jacky4566/BRZFRS_Breakout_withCAN/6376430-2/6376430-2.step

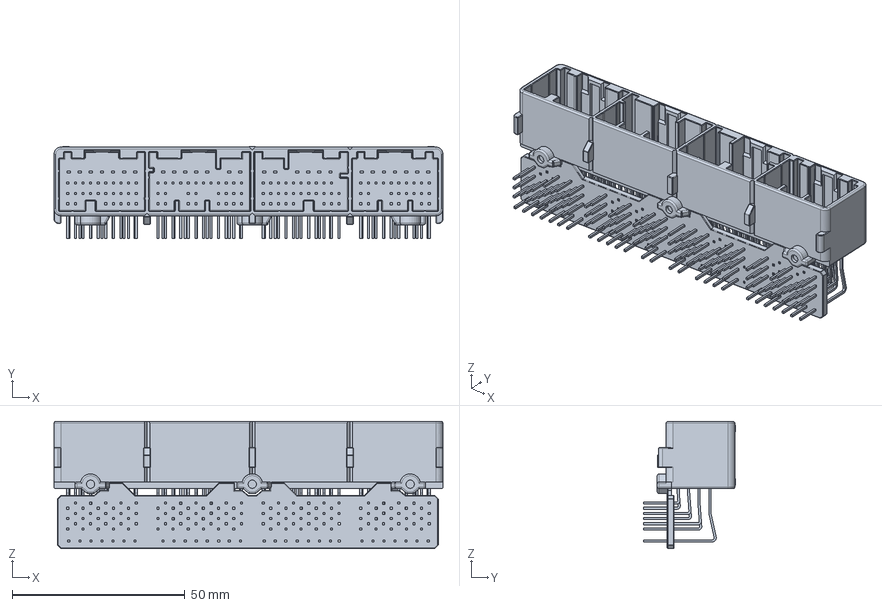
[picture p2: CAD file, 2026-10-14]
6376430-2/6376430-2.step
112.7 x 26.7 x 36.9 mm
