jacky4566/BRZFRS_Breakout_withCAN/BRZ_Breakout_withCAN.kicad_pcb

## KiCad design BRZ_Breakout_withCAN.kicad_pcb (2026-10-14)

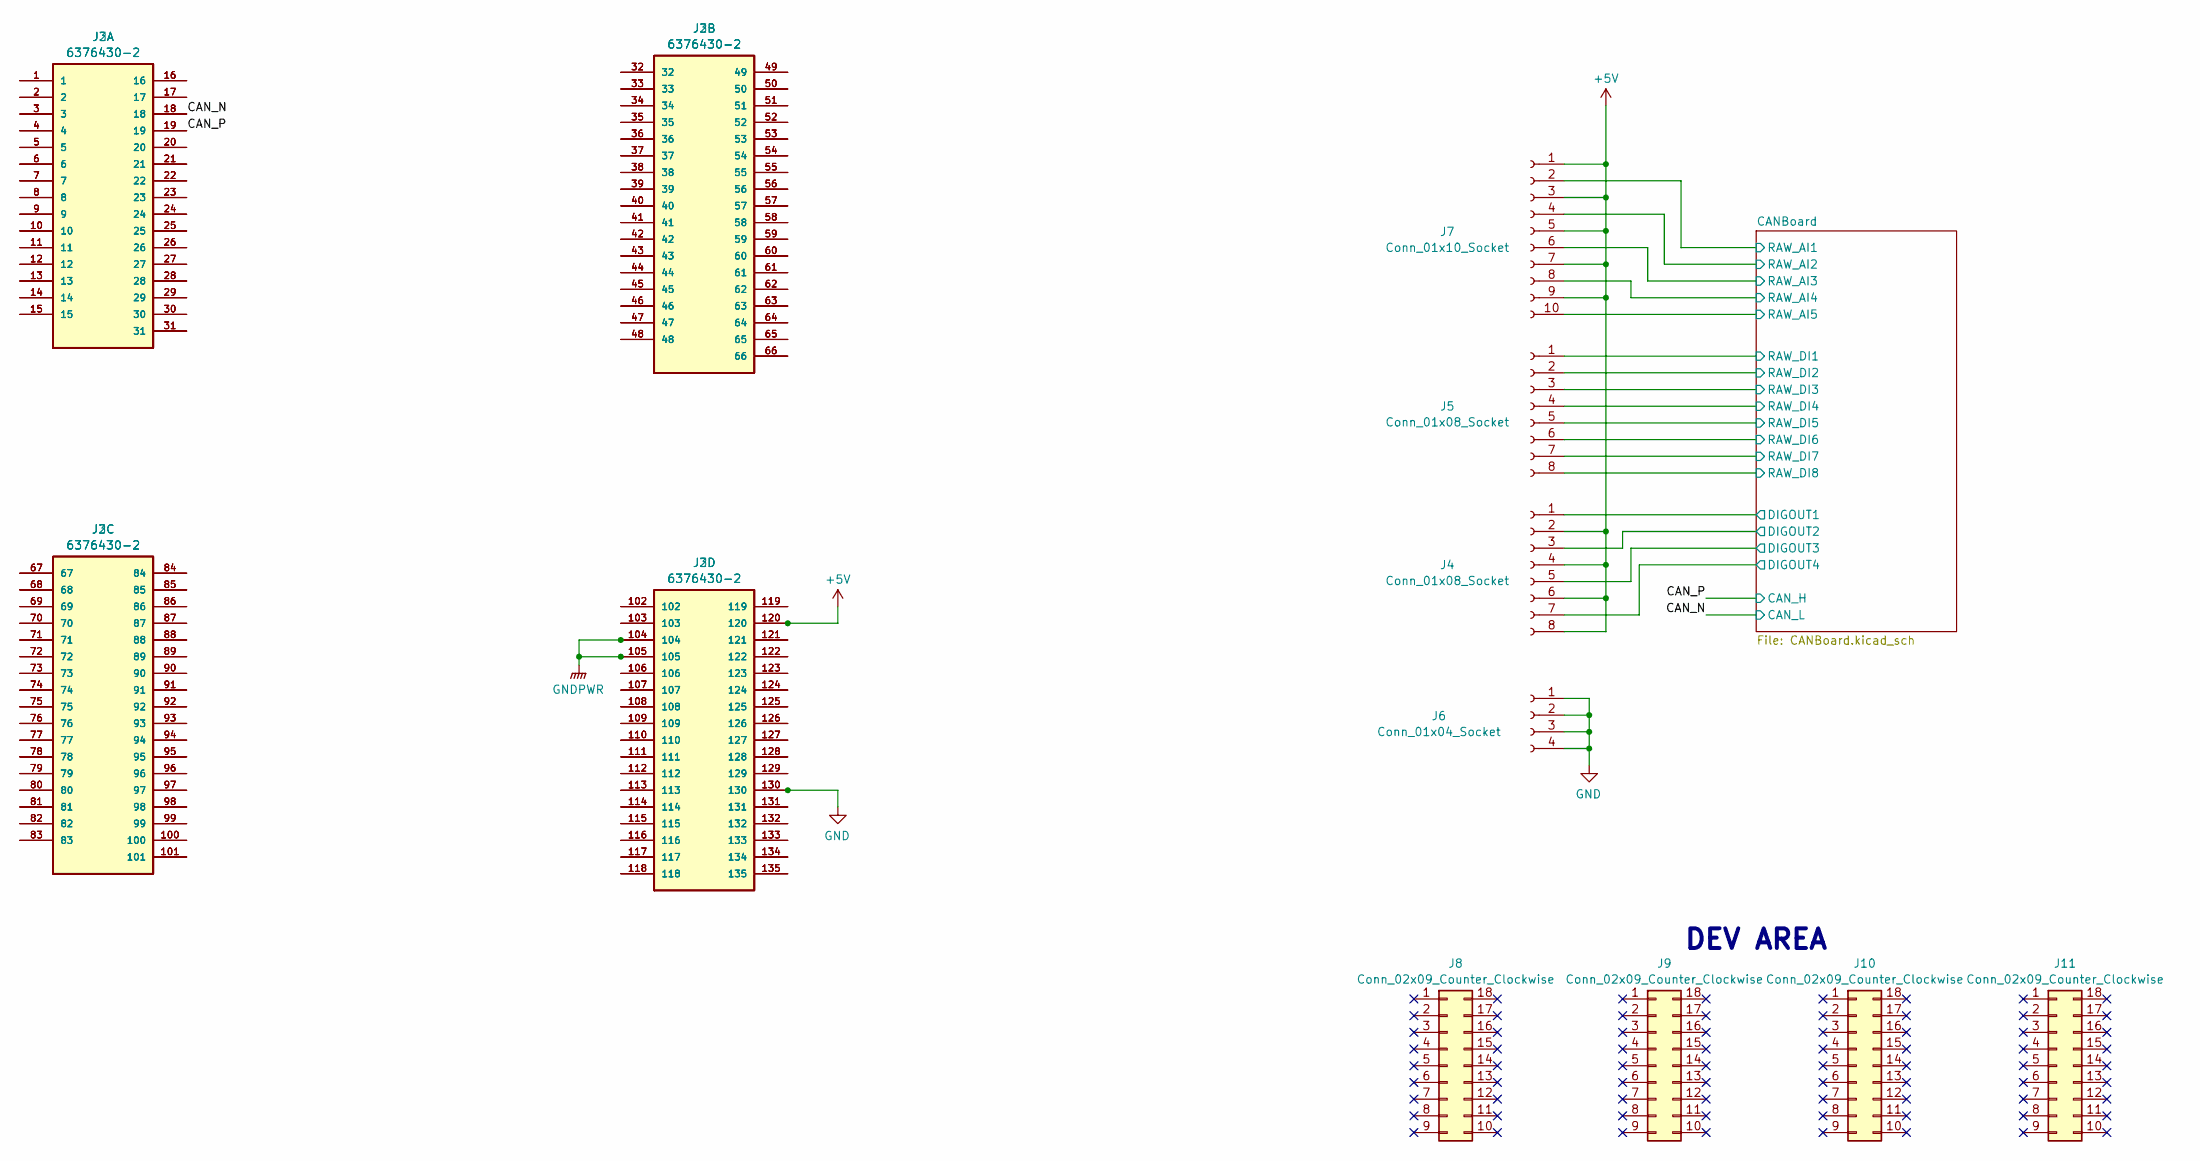
[picture p3: schematic BRZ_Breakout_withCAN.kicad_sch]

Parts:
J2, J3: 6376430-2; TE_6376430-2; MPN 6376430-2; Digi-Key_PN 17-6376430-2-ND
J4, J5: Conn_01x08_Socket; PinHeader_1x08_P2.54mm_Vertical
J6: Conn_01x04_Socket; PinHeader_1x04_P2.54mm_Vertical
J7: Conn_01x10_Socket; PinHeader_1x10_P2.54mm_Vertical
J8, J9, J10, J11: Conn_02x09_Counter_Clockwise; PinHeader_2x09_P2.54mm_Vertical

Connections:
+5V: J2.120, J3.120, J4.2, J4.4, J4.6, J4.8, J7.1, J7.3, J7.5, J7.7, J7.9; also elsewhere on the board
/CANBoard/DIGOUT1: J4.1; also elsewhere on the board
/CANBoard/DIGOUT2: J4.3; also elsewhere on the board
/CANBoard/DIGOUT3: J4.5; also elsewhere on the board
/CANBoard/DIGOUT4: J4.7; also elsewhere on the board
/CANBoard/RAW_AI1: J7.2; also elsewhere on the board
/CANBoard/RAW_AI2: J7.4; also elsewhere on the board
/CANBoard/RAW_AI3: J7.6; also elsewhere on the board
/CANBoard/RAW_AI4: J7.8; also elsewhere on the board
/CANBoard/RAW_AI5: J7.10; also elsewhere on the board
/CANBoard/RAW_DI1: J5.1; also elsewhere on the board
/CANBoard/RAW_DI2: J5.2; also elsewhere on the board
/CANBoard/RAW_DI3: J5.3; also elsewhere on the board
/CANBoard/RAW_DI4: J5.4; also elsewhere on the board
/CANBoard/RAW_DI5: J5.5; also elsewhere on the board
/CANBoard/RAW_DI6: J5.6; also elsewhere on the board
/CANBoard/RAW_DI7: J5.7; also elsewhere on the board
/CANBoard/RAW_DI8: J5.8; also elsewhere on the board
/CAN_N: J2.18, J3.18; also elsewhere on the board
/CAN_P: J2.19, J3.19; also elsewhere on the board
GND: J2.130, J3.130, J6.1, J6.2, J6.3, J6.4; also elsewhere on the board
GNDPWR: J2.104, J2.105, J3.104, J3.105; also elsewhere on the board
unnamed: J2.1, J3.1
unnamed: J2.2, J3.2
unnamed: J2.3, J3.3
unnamed: J2.4, J3.4
unnamed: J2.5, J3.5
unnamed: J2.6, J3.6
unnamed: J2.7, J3.7
unnamed: J2.8, J3.8
unnamed: J2.9, J3.9
unnamed: J2.10, J3.10
unnamed: J2.11, J3.11
unnamed: J2.12, J3.12
unnamed: J2.13, J3.13
unnamed: J2.14, J3.14
unnamed: J2.15, J3.15
unnamed: J2.16, J3.16
unnamed: J2.17, J3.17
unnamed: J2.20, J3.20
unnamed: J2.21, J3.21
unnamed: J2.22, J3.22
unnamed: J2.23, J3.23
unnamed: J2.24, J3.24
unnamed: J2.25, J3.25
unnamed: J2.26, J3.26
unnamed: J2.27, J3.27
unnamed: J2.28, J3.28
unnamed: J2.29, J3.29
unnamed: J2.30, J3.30
unnamed: J2.31, J3.31
unnamed: J2.32, J3.32
unnamed: J2.33, J3.33
unnamed: J2.34, J3.34
unnamed: J2.35, J3.35
unnamed: J2.36, J3.36
unnamed: J2.37, J3.37
unnamed: J2.38, J3.38
unnamed: J2.39, J3.39
unnamed: J2.40, J3.40
unnamed: J2.41, J3.41
unnamed: J2.42, J3.42
unnamed: J2.43, J3.43
unnamed: J2.44, J3.44
unnamed: J2.45, J3.45
unnamed: J2.46, J3.46
unnamed: J2.47, J3.47
unnamed: J2.48, J3.48
unnamed: J2.49, J3.49
unnamed: J2.50, J3.50
unnamed: J2.51, J3.51
unnamed: J2.52, J3.52
unnamed: J2.53, J3.53
unnamed: J2.54, J3.54
unnamed: J2.55, J3.55
unnamed: J2.56, J3.56
unnamed: J2.57, J3.57
unnamed: J2.58, J3.58
unnamed: J2.59, J3.59
unnamed: J2.60, J3.60
unnamed: J2.61, J3.61
unnamed: J2.62, J3.62
unnamed: J2.63, J3.63
unnamed: J2.64, J3.64
unnamed: J2.65, J3.65
unnamed: J2.66, J3.66
unnamed: J2.67, J3.67
unnamed: J2.68, J3.68
unnamed: J2.69, J3.69
unnamed: J2.70, J3.70
unnamed: J2.71, J3.71
unnamed: J2.72, J3.72
unnamed: J2.73, J3.73
unnamed: J2.74, J3.74
unnamed: J2.75, J3.75
unnamed: J2.76, J3.76
unnamed: J2.77, J3.77
unnamed: J2.78, J3.78
unnamed: J2.79, J3.79
unnamed: J2.80, J3.80
unnamed: J2.81, J3.81
unnamed: J2.82, J3.82
unnamed: J2.83, J3.83
unnamed: J2.84, J3.84
unnamed: J2.85, J3.85
unnamed: J2.86, J3.86
unnamed: J2.87, J3.87
unnamed: J2.88, J3.88
unnamed: J2.89, J3.89
unnamed: J2.90, J3.90
unnamed: J2.91, J3.91
unnamed: J2.92, J3.92
unnamed: J2.93, J3.93
unnamed: J2.94, J3.94
unnamed: J2.95, J3.95
unnamed: J2.96, J3.96
unnamed: J2.97, J3.97
unnamed: J2.98, J3.98
unnamed: J2.99, J3.99
unnamed: J2.100, J3.100
unnamed: J2.101, J3.101
unnamed: J2.102, J3.102
unnamed: J2.103, J3.103
unnamed: J2.106, J3.106
unnamed: J2.107, J3.107
unnamed: J2.108, J3.108
unnamed: J2.109, J3.109
unnamed: J2.110, J3.110
unnamed: J2.111, J3.111
unnamed: J2.112, J3.112
unnamed: J2.113, J3.113
unnamed: J2.114, J3.114
unnamed: J2.115, J3.115
unnamed: J2.116, J3.116
unnamed: J2.117, J3.117
unnamed: J2.118, J3.118
unnamed: J2.119, J3.119
unnamed: J2.121, J3.121
unnamed: J2.122, J3.122
unnamed: J2.123, J3.123
unnamed: J2.124, J3.124
unnamed: J2.125, J3.125
unnamed: J2.126, J3.126
unnamed: J2.127, J3.127
unnamed: J2.128, J3.128
unnamed: J2.129, J3.129
unnamed: J2.131, J3.131
unnamed: J2.132, J3.132
unnamed: J2.133, J3.133
unnamed: J2.134, J3.134
unnamed: J2.135, J3.135

Notes on the sheet:
DEV AREA

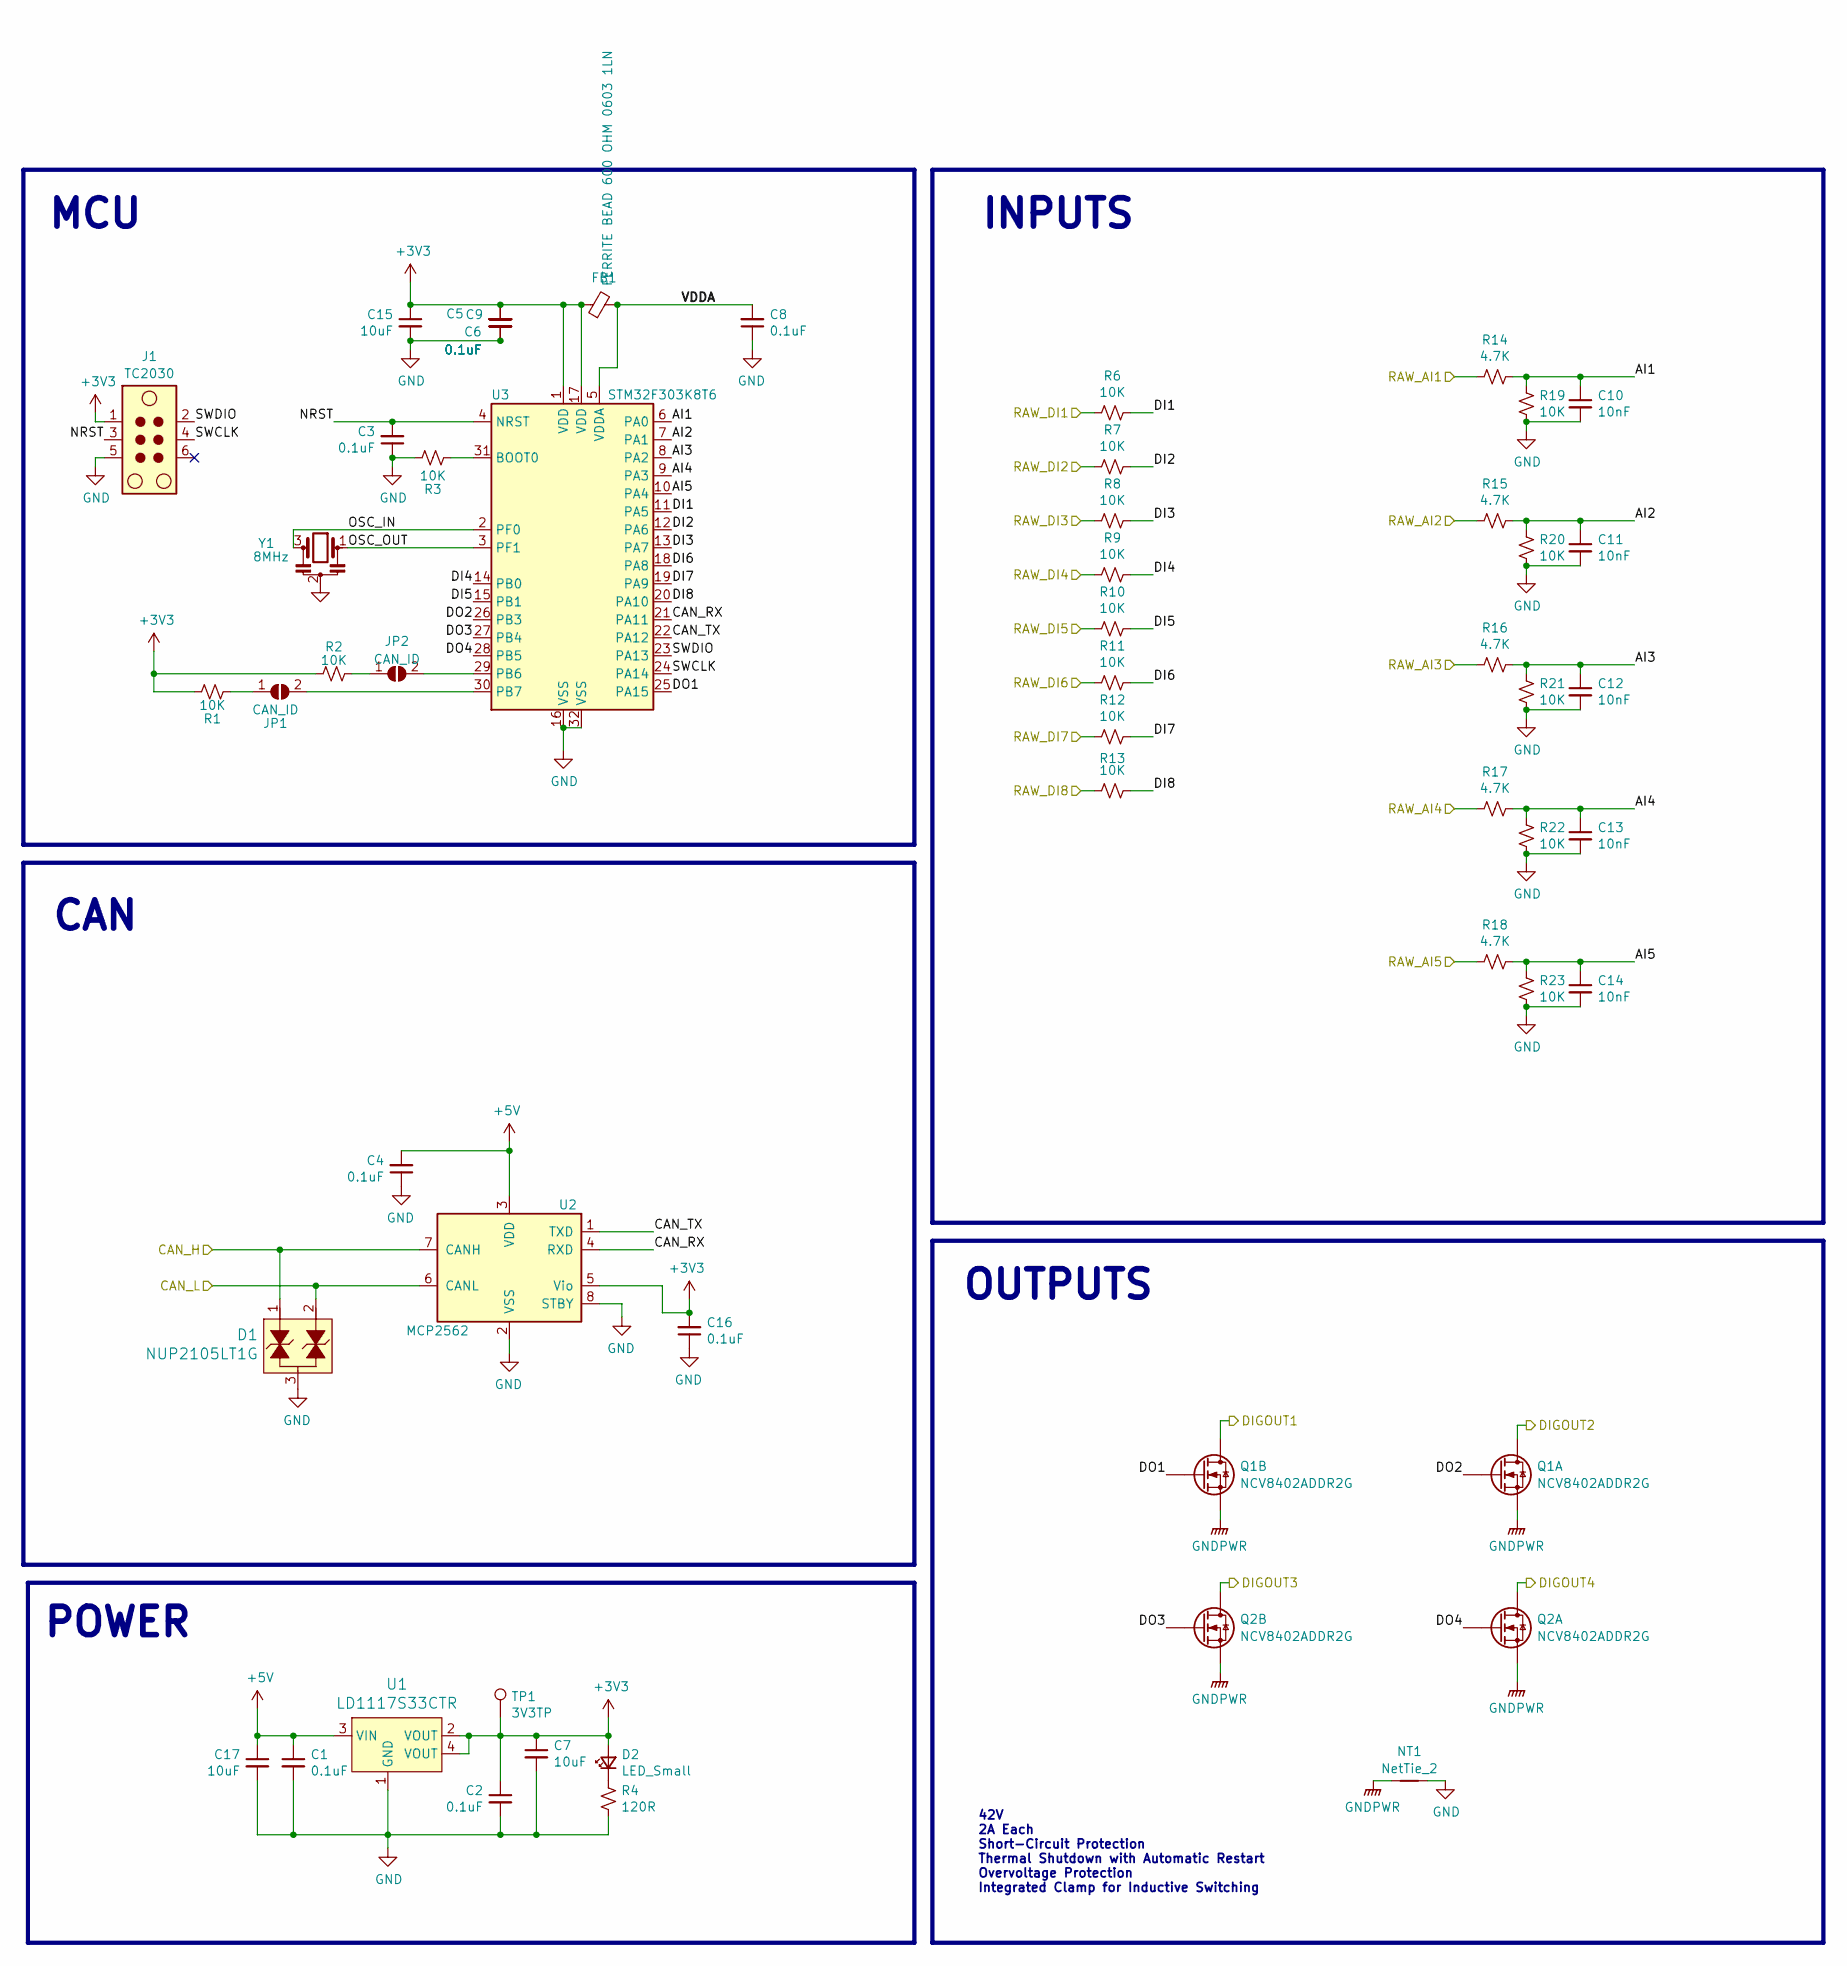
[picture p4: schematic CANBoard.kicad_sch]

Parts:
C1, C2, C3, C4, C5, C6, C8, C9, C16: 0.1uF; C_0603_1608Metric; MPN C0603C104K3RACTU; Digi-Key_PN 399-C0603C104K3RACTUCT-ND
C7, C15, C17: 10uF; C_0805_2012Metric; MPN GRM21BR61E106MA73L; Digi-Key_PN 490-10748-1-ND
C10, C11, C12, C13, C14: 10nF; C_0603_1608Metric; MPN C0603C103K5RACTU; Digi-Key_PN 399-C0603C103K5RACTUCT-ND
D1: NUP2105LT1G; SOT-23-3; MPN NUP2105LT1G; Digi-Key_PN NUP2105LT1GOSCT-ND
D2: LED_Small; LED_0805_2012Metric; MPN LY R976-PS-36-0-20-R18; Digi-Key_PN 475-2560-1-ND
FB1: FERRITE BEAD 600 OHM 0603 1LN; R_0603_1608Metric; MPN BLM18AG601SH1D; Digi-Key_PN 490-7811-1-ND
J1: TC2030; Tag-Connect_TC2030-IDC-NL_2x03_P1.27mm_Vertical
JP1, JP2: CAN_ID; SolderJumper-2_P1.3mm_Open_RoundedPad1.0x1.5mm
NT1: NetTie_2; NetTie-2_THT_Pad0.3mm
Q1, Q2: NCV8402ADDR2G; SOIC-8_3.9x4.9mm_P1.27mm; MPN NCV8402ADDR2G; Digi-Key_PN NCV8402ADDR2GOSCT-ND
R1, R2, R3, R6, R7, R8, R9, R10, R11, R12, R13, R19, R20, R21, R22, R23: 10K; R_0603_1608Metric; MPN CRCW060310K0FKEA; Digi-Key_PN 541-10.0KHCT-ND
R4: 120R; R_0603_1608Metric; MPN RC0603JR-07120RL; Digi-Key_PN 311-120GRCT-ND
R14, R15, R16, R17, R18: 4.7K; R_0603_1608Metric; MPN CRCW06034K70FKEA; Digi-Key_PN 541-4.70KHCT-ND
TP1: 3V3TP; TestPoint_Pad_D1.0mm
U1: LD1117S33CTR; SOT-223; MPN LD1117S33CTR; Digi-Key_PN 497-1241-1-ND
U2: MCP2562; SOIC-8_3.9x4.9mm_P1.27mm; MPN MCP2562-H/SN; Digi-Key_PN MCP2562-H/SN-ND
U3: STM32F303K8T6; LQFP-32_7x7mm_P0.8mm; MPN STM32F303K8T6; Digi-Key_PN 497-15828-ND
Y1: 8MHz; Resonator_SMD_Murata_CSTxExxV-3Pin_3.0x1.1mm; MPN 490-17959-1-ND; Digi-Key_PN 490-17959-1-ND

Connections:
+3V3: C2.1, C5.2, C6.2, C7.1, C9.2, C15.1, C16.2, D2.2 (A), FB1.1, J1.1, R1.2, R2.2, TP1.1 (1_1), U1.2 (VOUT), U1.4 (VOUT), U2.5 (Vio), U3.1 (VDD), U3.17 (VDD)
+5V: C1.1, C4.2, C17.1, U1.3 (VIN), U2.3 (VDD); also elsewhere on the board
/CANBoard/AI1: C10.1, R14.1, R19.2, U3.6 (PA0)
/CANBoard/AI2: C11.1, R15.1, R20.2, U3.7 (PA1)
/CANBoard/AI3: C12.1, R16.1, R21.2, U3.8 (PA2)
/CANBoard/AI4: C13.1, R17.1, R22.2, U3.9 (PA3)
/CANBoard/AI5: C14.1, R18.1, R23.2, U3.10 (PA4)
/CANBoard/CAN_RX: U2.4 (RXD), U3.21 (PA11)
/CANBoard/CAN_TX: U2.1 (TXD), U3.22 (PA12)
/CANBoard/DI1: R6.1, U3.11 (PA5)
/CANBoard/DI2: R7.1, U3.12 (PA6)
/CANBoard/DI3: R8.1, U3.13 (PA7)
/CANBoard/DI4: R9.1, U3.14 (PB0)
/CANBoard/DI5: R10.1, U3.15 (PB1)
/CANBoard/DI6: R11.1, U3.18 (PA8)
/CANBoard/DI7: R12.1, U3.19 (PA9)
/CANBoard/DI8: R13.1, U3.20 (PA10)
/CANBoard/DIGOUT1: Q1.5 (D), Q1.6 (D); also elsewhere on the board
/CANBoard/DIGOUT2: Q1.7 (D), Q1.8 (D); also elsewhere on the board
/CANBoard/DIGOUT3: Q2.5 (D), Q2.6 (D); also elsewhere on the board
/CANBoard/DIGOUT4: Q2.7 (D), Q2.8 (D); also elsewhere on the board
/CANBoard/DO1: Q1.4 (G), U3.25 (PA15)
/CANBoard/DO2: Q1.2 (G), U3.26 (PB3)
/CANBoard/DO3: Q2.4 (G), U3.27 (PB4)
/CANBoard/DO4: Q2.2 (G), U3.28 (PB5)
/CANBoard/NRST: C3.2, J1.3, U3.4 (NRST)
/CANBoard/OSC_IN: U3.2 (PF0), Y1.3
/CANBoard/OSC_OUT: U3.3 (PF1), Y1.1
/CANBoard/RAW_AI1: R14.2; also elsewhere on the board
/CANBoard/RAW_AI2: R15.2; also elsewhere on the board
/CANBoard/RAW_AI3: R16.2; also elsewhere on the board
/CANBoard/RAW_AI4: R17.2; also elsewhere on the board
/CANBoard/RAW_AI5: R18.2; also elsewhere on the board
/CANBoard/RAW_DI1: R6.2; also elsewhere on the board
/CANBoard/RAW_DI2: R7.2; also elsewhere on the board
/CANBoard/RAW_DI3: R8.2; also elsewhere on the board
/CANBoard/RAW_DI4: R9.2; also elsewhere on the board
/CANBoard/RAW_DI5: R10.2; also elsewhere on the board
/CANBoard/RAW_DI6: R11.2; also elsewhere on the board
/CANBoard/RAW_DI7: R12.2; also elsewhere on the board
/CANBoard/RAW_DI8: R13.2; also elsewhere on the board
/CANBoard/SWCLK: J1.4, U3.24 (PA14)
/CANBoard/SWDIO: J1.2, U3.23 (PA13)
/CANBoard/VDDA: C8.2, FB1.2, U3.5 (VDDA)
/CAN_N: D1.2, U2.6 (CANL); also elsewhere on the board
/CAN_P: D1.1, U2.7 (CANH); also elsewhere on the board
GND: C1.2, C2.2, C3.1, C4.1, C5.1, C6.1, C7.2, C8.1, C9.1, C10.2, C11.2, C12.2, C13.2, C14.2, C15.2, C16.1, C17.2, D1.3, J1.5, NT1.2, R3.2, R4.1, R19.1, R20.1, R21.1, R22.1, R23.1, U1.1 (GND), U2.2 (VSS), U2.8 (STBY), U3.16 (VSS), U3.32 (VSS), Y1.2; also elsewhere on the board
GNDPWR: NT1.1, Q1.1 (S), Q1.3 (S), Q2.1 (S), Q2.3 (S); also elsewhere on the board
unnamed: D2.1 (K), R4.2
unnamed: JP1.1 (A), R1.1
unnamed: JP1.2 (B), U3.30 (PB7)
unnamed: JP2.1 (A), R2.1
unnamed: JP2.2 (B), U3.29 (PB6)
unnamed: R3.1, U3.31 (BOOT0)

Notes on the sheet:
OUTPUTS
POWER
MCU
INPUTS
42V 2A Each Short−Circuit Protection Thermal Shutdown with Automatic Restart Overvoltage Protection Integrated Clamp for Inductive Switching
CAN

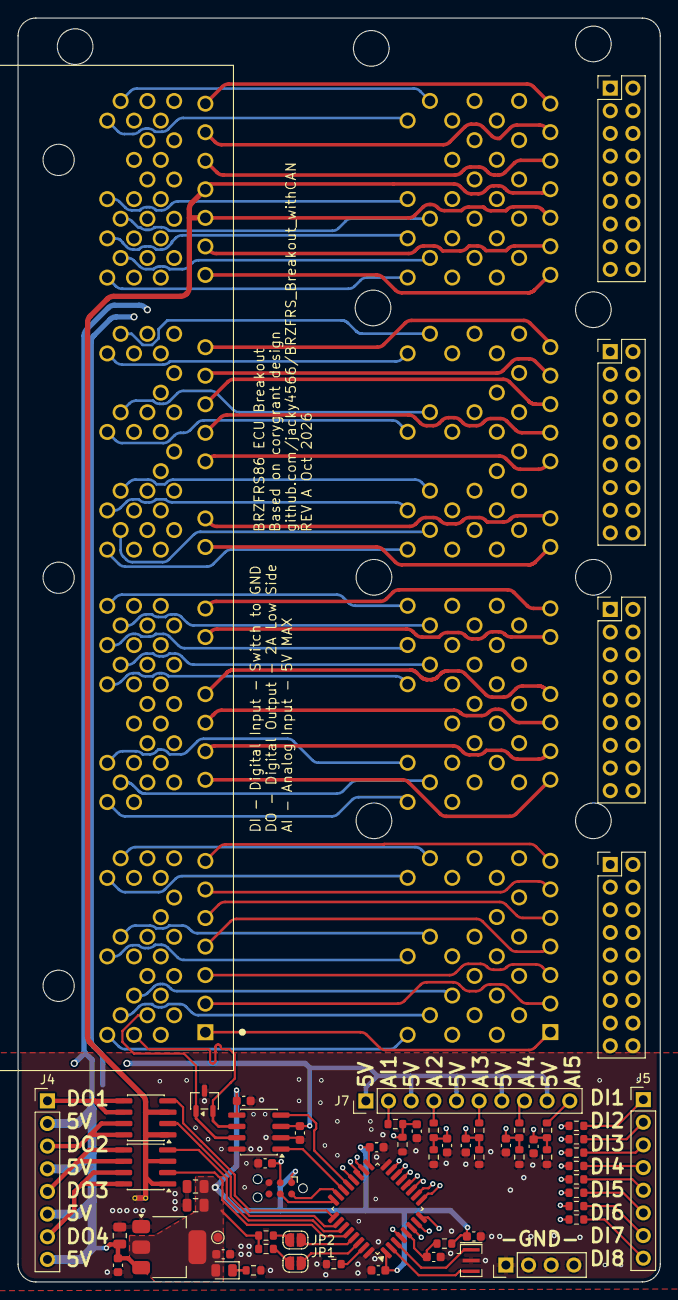
[picture p5: board BRZ_Breakout_withCAN.kicad_pcb from above]

Board: 4 copper layers, 72.0 x 141.7 mm, 63 parts (0 on the bottom side), 183 nets.
