jacky4566/BRZFRS_Breakout_withCAN/(commit log)

2026-10-14 Initial upload
    [6376430-2.step, BRZ_Breakout_withCAN.kicad_pcb, BRZ_Breakout_withCAN.kicad_sch, CANBoard.kicad_sch]
2026-10-14 Add images
    [BRZ_Breakout_withCAN.kicad_pcb]
2026-10-14 Fix the squiggles
    [BRZ_Breakout_withCAN.kicad_pcb]
2026-10-14 Update Outline, Add breadboard area
    [BRZ_Breakout_withCAN.kicad_pcb, BRZ_Breakout_withCAN.kicad_sch]
2026-10-14 Add warning
    [BRZ_Breakout_withCAN.kicad_pcb]
